alexo-git/sonar-2000/sonar-2000.pdf

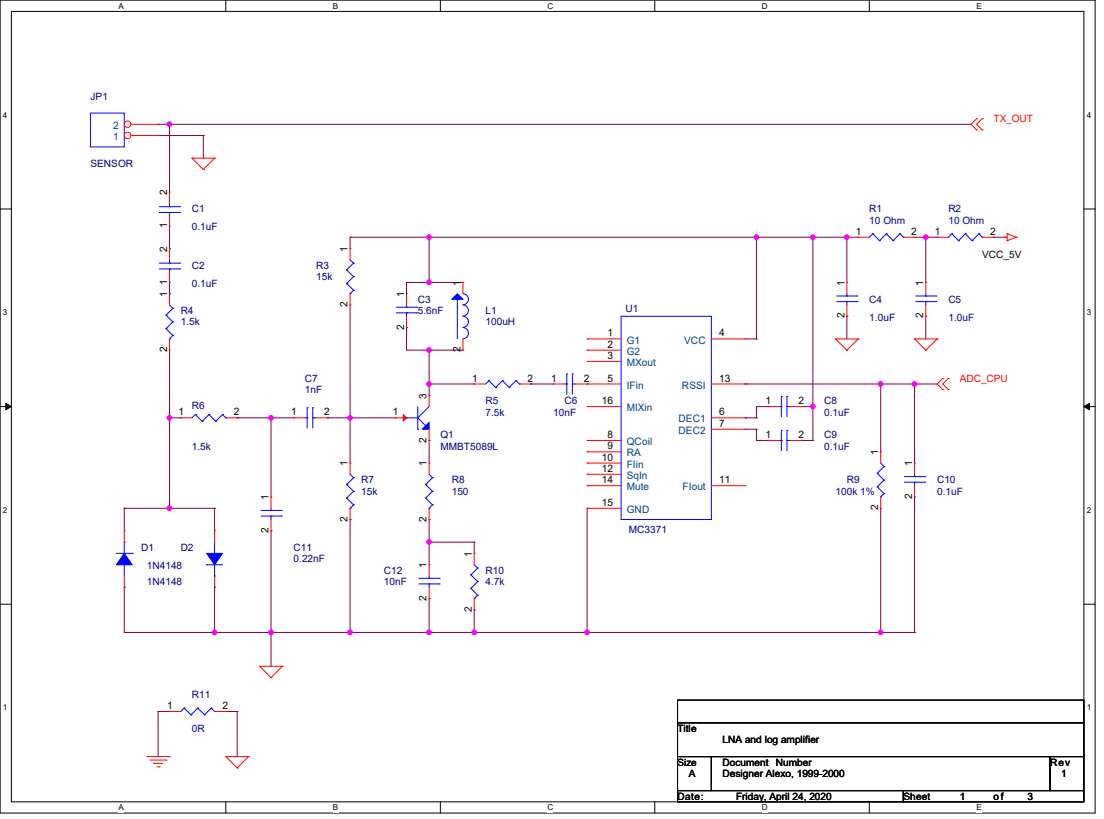
[picture p1: page 1]

LNA and log amplifier

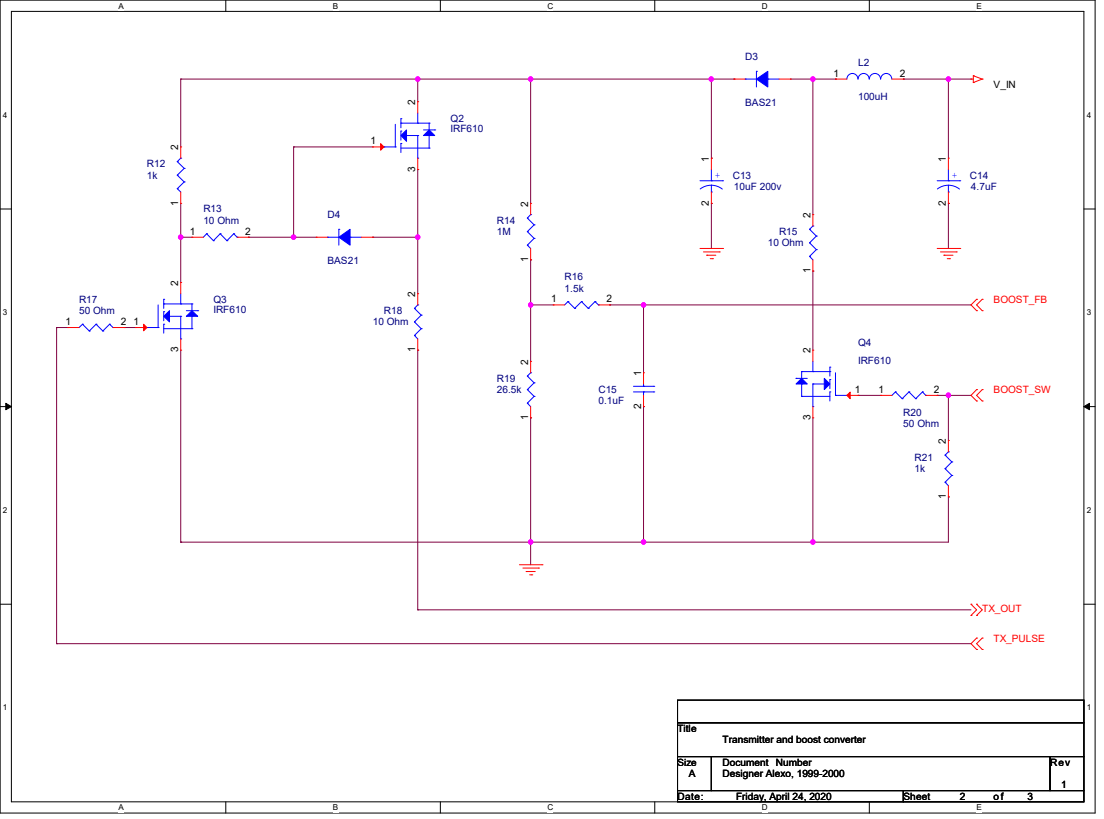
[picture p2: page 2]

Transmitter and boost converter

# JP2 STEPPER MOTOR1

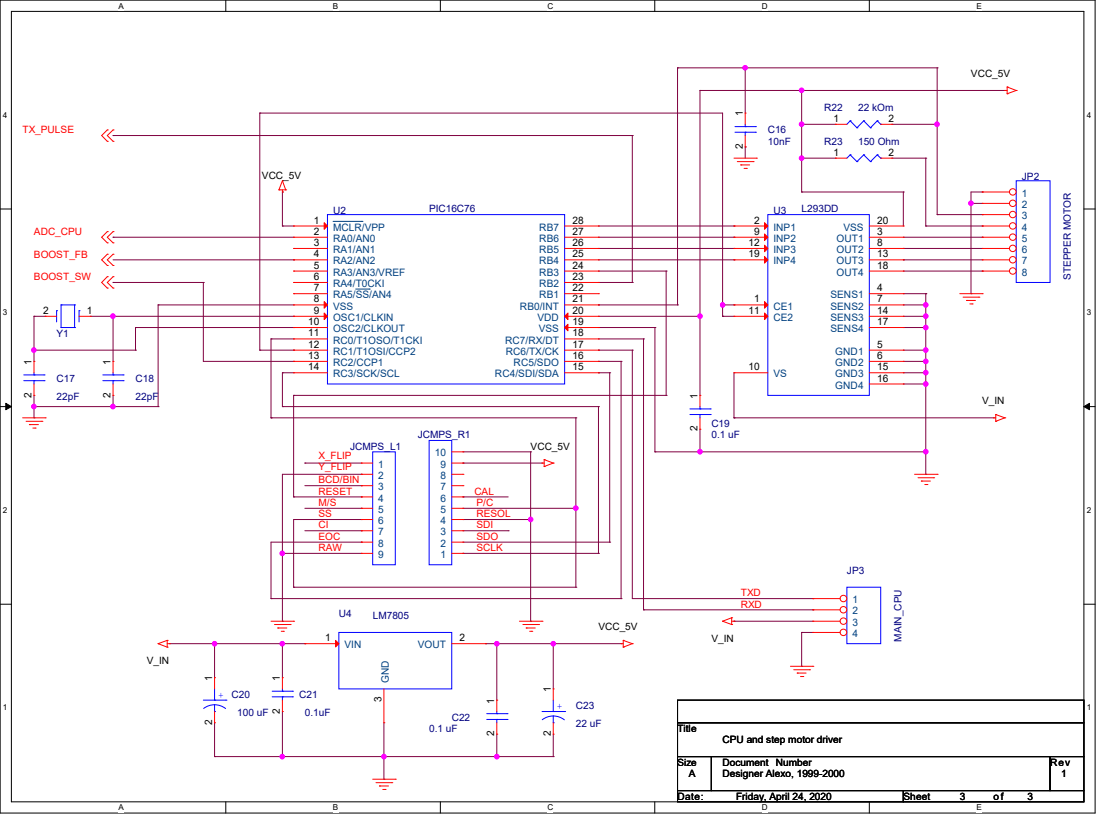
[picture p3: page 3]

CPU and step motor driver
