alexo-git/sonar-2000/(list of files, drawings)

Other design files:
sonar-2000.DSN
