alexo-git/sonar-2000/(commit log)

2020-04-23 Initial version
    Initial version
    [sonar-2000.DSN]
2020-04-24 Fixed some bug on schematics
    [sonar-2000.DSN]
2020-04-24 Bug fix
    [sonar-2000.DSN]
